vwdiy2u/AlarmoOnetouch/alarmo_onetouch_button/IotWebConfUsing.h

/**
 * IotWebConfUsing.h -- IotWebConf is an ESP8266/ESP32
 *   non blocking WiFi/AP web configuration library for Arduino.
 *   https://github.com/prampec/IotWebConf
 *
 * Copyright (C) 2020 Balazs Kelemen <prampec+arduino@gmail.com>
 *
 * This software may be modified and distributed under the terms
 * of the MIT license.  See the LICENSE file for details.
 */

#ifndef IotWebConfUsing_h
#define IotWebConfUsing_h

// This "using" lines are just aliases, and should avoided.

using IotWebConfParameterGroup = iotwebconf::ParameterGroup;
using IotWebConfTextParameter = iotwebconf::TextParameter;
using IotWebConfPasswordParameter = iotwebconf::PasswordParameter;
using IotWebConfNumberParameter = iotwebconf::NumberParameter;
using IotWebConfCheckboxParameter = iotwebconf::CheckboxParameter;
using IotWebConfSelectParameter = iotwebconf::SelectParameter;

#endif
